Ibrahim-Touny/LockEn_STM32/laptop/_frame.jpg

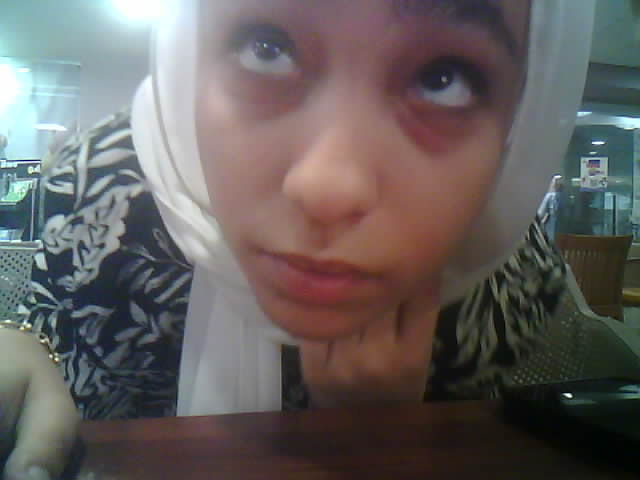
laptop/_frame.jpg
