Ibrahim-Touny/LockEn_STM32/Core/Inc/System/main.h

#define C4_Pin GPIO_PIN_0
#define C4_GPIO_Port GPIOA
#define C3_Pin GPIO_PIN_1
#define C3_GPIO_Port GPIOA
#define C2_Pin GPIO_PIN_4
#define C2_GPIO_Port GPIOB
#define C1_Pin GPIO_PIN_5
#define C1_GPIO_Port GPIOB
#define R4_Pin GPIO_PIN_12
#define R4_GPIO_Port GPIOB
#define R3_Pin GPIO_PIN_13
#define R3_GPIO_Port GPIOB
#define R2_Pin GPIO_PIN_14
#define R2_GPIO_Port GPIOB
#define R1_Pin GPIO_PIN_15
#define R1_GPIO_Port GPIOB
