Ibrahim-Touny/LockEn_STM32/(commit log)

2026-05-12 Initial commit: STM32 smart safe firmware with RFID, fingerprint, keypad, and tamper detection
2026-05-25 Better OOP and any 2 factors with small lag and small mistakes
    [R307.c, R307.h, auth_task.c, buzzer.h, display.c, fp_task.c]
2026-05-25 Update language settings and fix keypad return values
    [keypad.h]
2026-05-27 ESP32-Cam Imported
