Ibrahim-Touny/LockEn_STM32/(notices)

Notices in the files:
Core/Inc/System/main.h:
Copyright (c) 2026 STMicroelectronics.
All rights reserved.
This software is licensed under terms that can be found in the LICENSE file
